GiuMG/Trackduino2/Docs/Install_1541.JPG

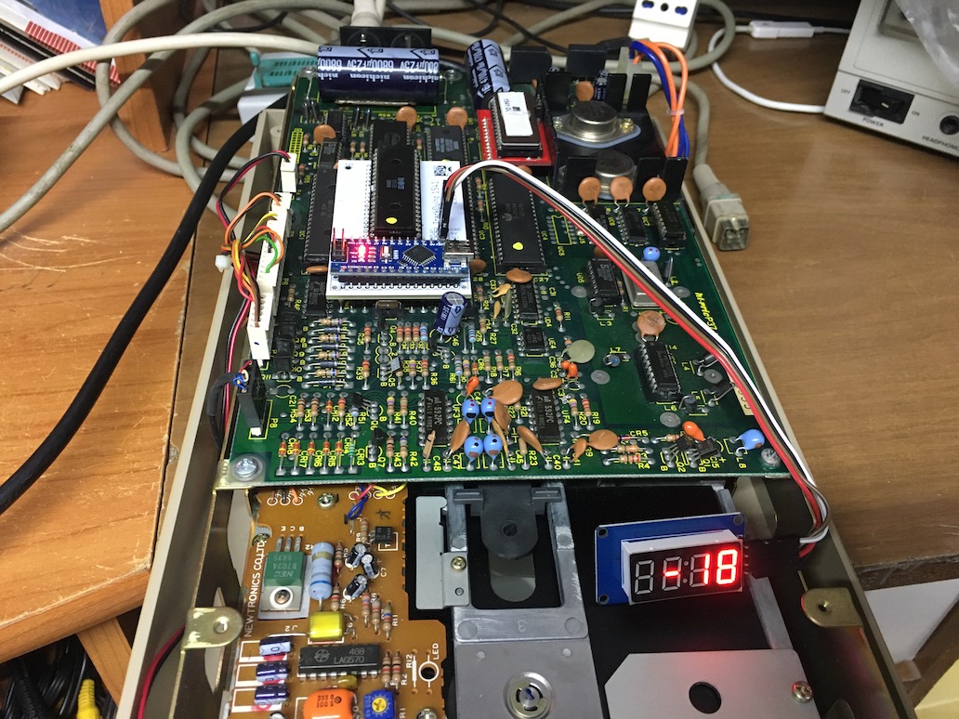
Docs/Install_1541.JPG
