GiuMG/Trackduino2/Docs/Lcd_Test.JPG

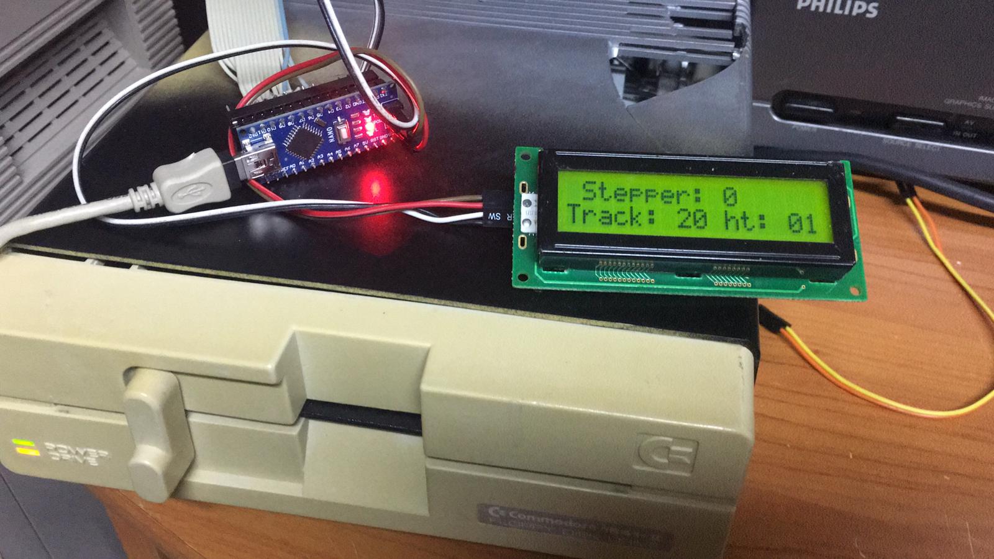
Docs/Lcd_Test.JPG
