GiuMG/Trackduino2/Docs/1541_blue.JPG

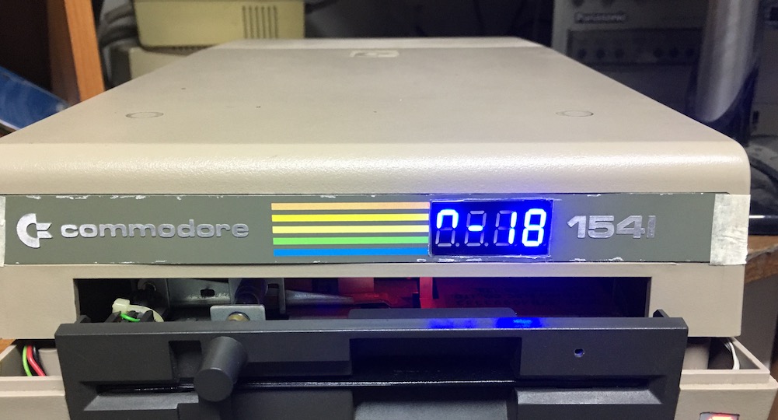
Docs/1541_blue.JPG
