GiuMG/Trackduino2/Docs/1541_red.JPG

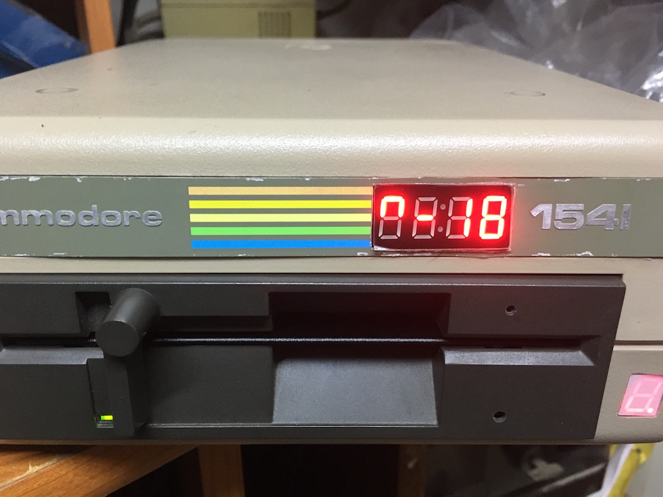
Docs/1541_red.JPG
