GiuMG/Trackduino2/Docs/Adapter.JPG

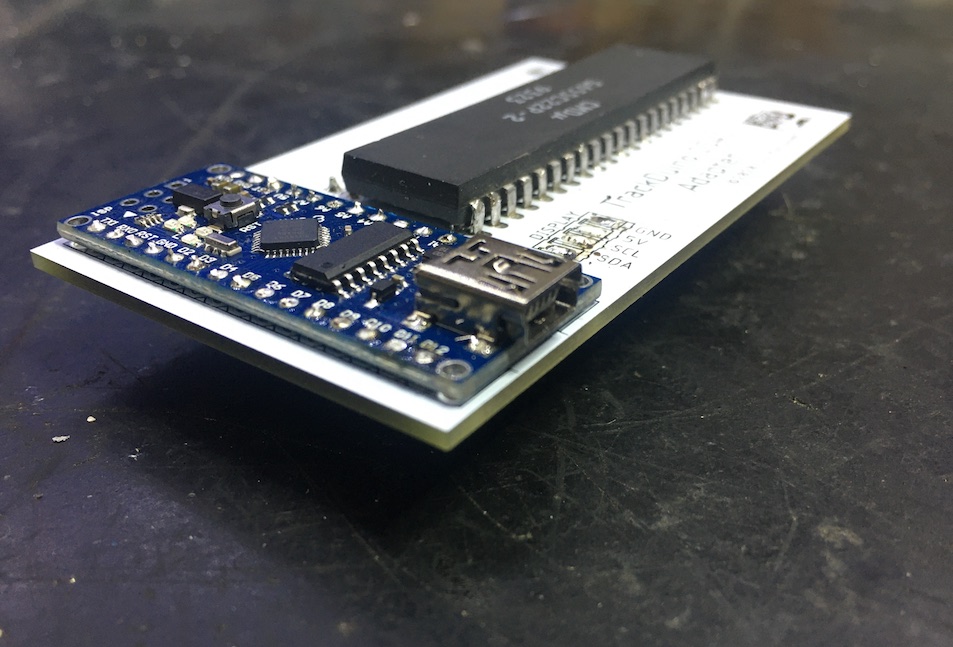
Docs/Adapter.JPG
