GiuMG/Trackduino2/Docs/IMG_0912.JPG

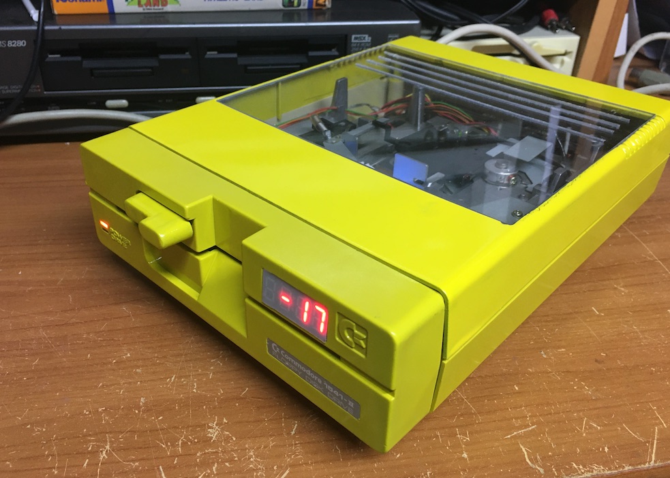
Docs/IMG_0912.JPG
