GiuMG/Trackduino2/Docs/Trackduino_Lcd.JPG

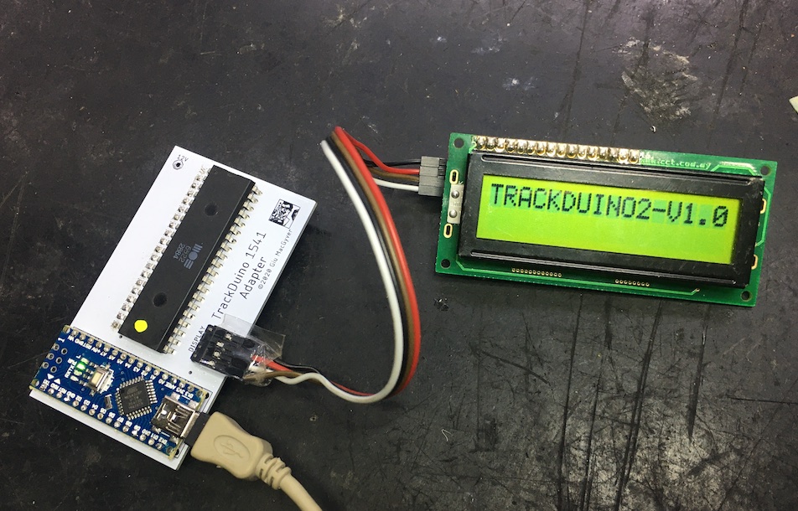
Docs/Trackduino_Lcd.JPG
