GiuMG/Trackduino2/Docs/Trackduino_Led.JPG

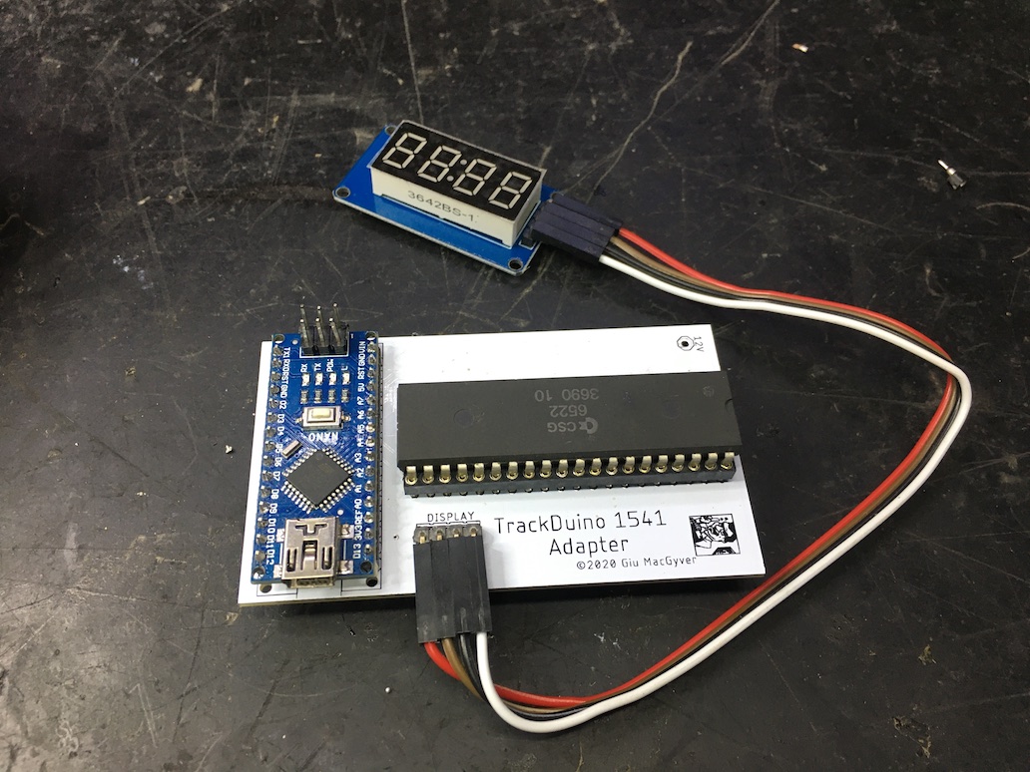
Docs/Trackduino_Led.JPG
