GiuMG/Trackduino2/Hardware/PCB_top.png

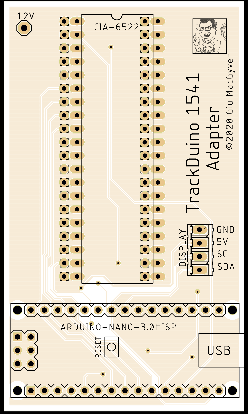
Hardware/PCB_top.png
