GiuMG/Trackduino2/Hardware/Trackduino_Pcb_Rev2.pdf

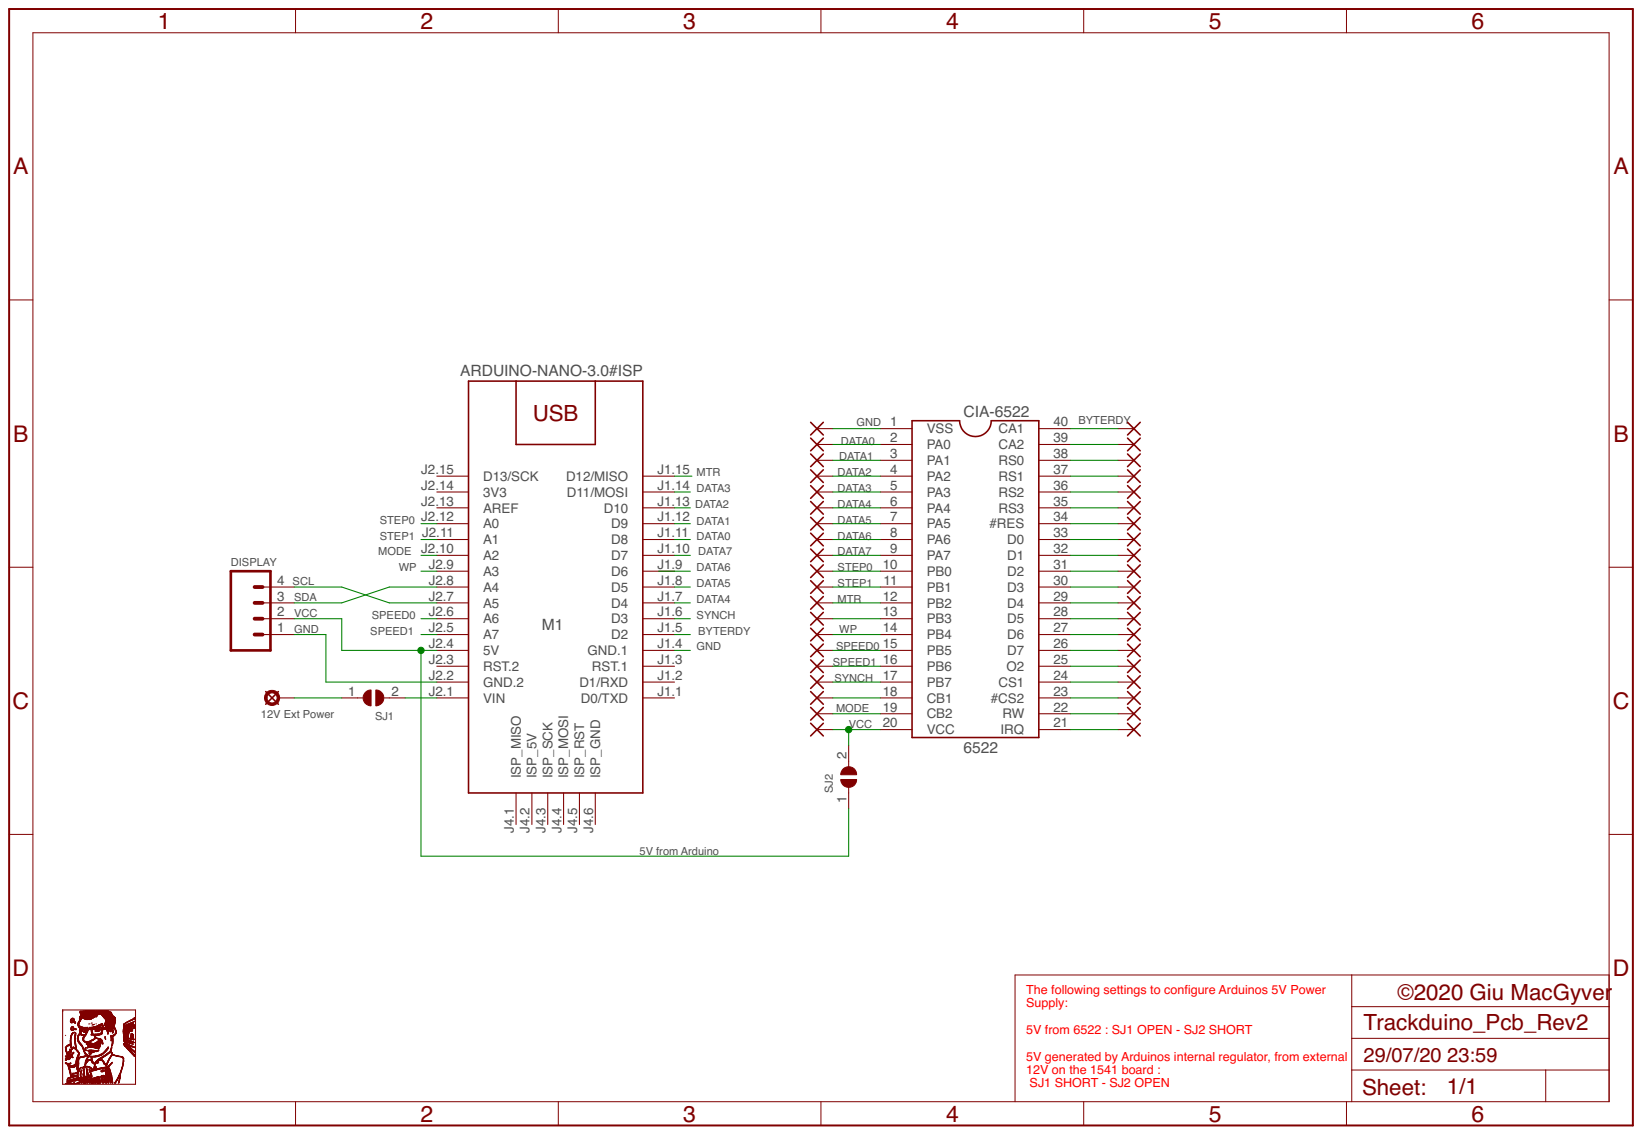
[picture p10: page 1]

The following settings to configure Arduinos 5V Power Supply: 5V from 6522 : SJ1 OPEN - SJ2 SHORT

5V generated by Arduinos internal regulator, from external 12V on the 1541 board : SJ1 SHORT - SJ2 OPEN
