GiuMG/Trackduino2/Hardware/Trackduino_original.pdf

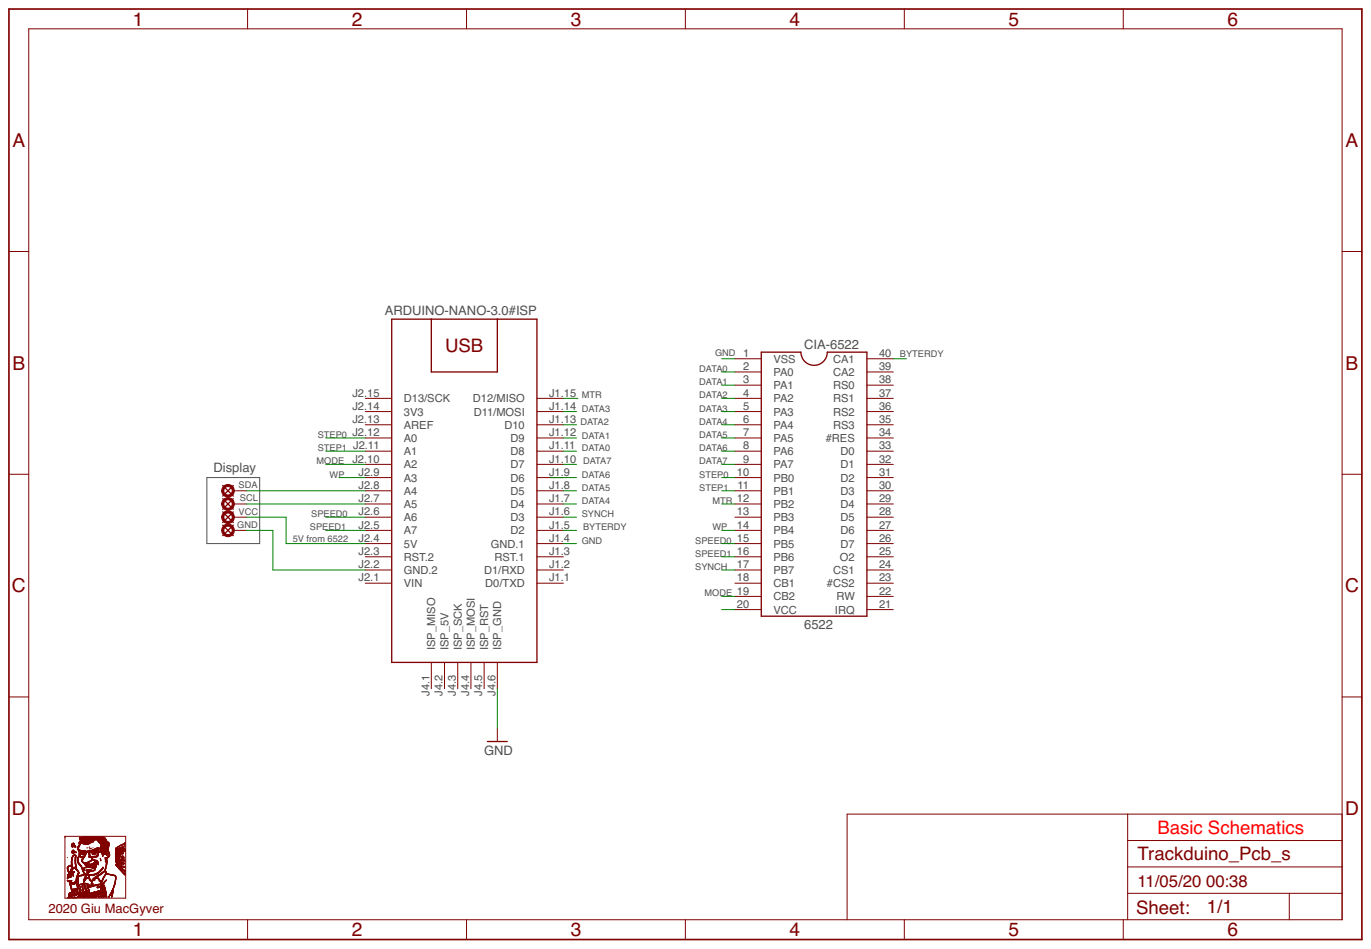
[picture p11: page 1]
