GiuMG/Trackduino2/Docs/Install_1541-2.JPG

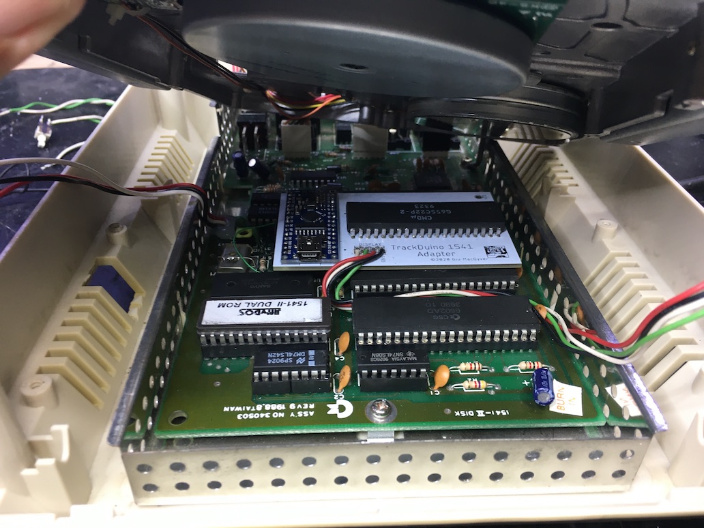
Docs/Install_1541-2.JPG
