GiuMG/Trackduino2/(notices)

Notices in the files:
Hardware/Arduino/Track_Anzeige_04_poll/gcr.ino:
modify it under the terms of the GNU General Public License
